CrochsDevs/Water-Monitoring-System/(commit log)

2026-05-26 feat: Creating history for three devices including the history of readings
2026-05-27 Add comprehensive Data Flow Diagram with both systems, processes, decisions, and logic
2026-05-31 Add Arduino sketches, serial tools, and finalized Phase 2 procurement
    Arduino:
    - arduino/rice_field_monitor_sim800l.ino — SIM800L (GPRS + SMS fallback)
    - arduino/rice_field_monitor_air780e.ino — Air780E 4G LTE (HTTP + SMS)
    Tools:
    - tools/serial_monitor.py — Full serial monitor with JSON parsing
    - tools/quick_monitor.py — Minimal raw serial reader
    Docs:
    - docs/BENCH_TESTING.md — 6-phase bench testing protocol
    - docs/CLIENT_DOCUMENTATION.md — Full device spec for thesis
    - docs/PROCUREMENT.md — Finalized with 10W panel, 7AH battery, field visit note
2026-06-01 Add minimal Phase 2 buy list — 7 essential items for client procurement
2026-06-01 Update Phase 2 minimal list — add mounting hardware (clamps, brackets, bolts)
2026-06-02 Deploy Docker stack: MySQL + PHP/Nginx dashboard, API endpoint, serial bridge, Arduino JSON output
    - Docker Compose: MySQL 8.0, PHP 8.2-FPM, Nginx, phpMyAdmin
    - New schema: water_level_readings table (device_id, level, distance, battery, signal, alert)
    - api/reading.php: POST endpoint for Arduino data (no auth, JSON body)
    - api/history_data.php: refactored for water level + battery chart data
    - pages/dashboard.php: water level gauge, battery/signal stats, 24h trends
    - pages/history.php: water level history with Chart.js, filter by hour/day/week/month/year
    - tools/serial_bridge.py: reads Arduino JSON over USB serial, POSTs to dashboard
    - Arduino sketch: JSON serial output for bridge, keep SIM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
2026-06-02 Dashboard: 3 devices (RF01/RF02/RF03), remove battery/signal, multi-device chart
    - Dashboard shows 3 device cards with colored gauges per device
    - 'Latest Water Level Retrieved' label with timestamp per card
    - Battery voltage and signal strength removed
    - History chart shows 3 lines (RF01=blue, RF02=green, RF03=amber)
    - history_data.php returns data for all 3 devices simultaneously
    - Seed data includes 500 readings each for RF01, RF02, RF03
    - Alerts list shows device_id tag
2026-06-06 Add mock deployment: USB bridge + wiring diagram + test sketch for 3 Unos
2026-06-06 Add wiring diagram: JSN-SR04T + LCD + reserved SIM pins for 3 Unos
2026-06-11 Add LTE bridge: Arduino USB -> PC -> A7680C USB -> 4G LTE -> Dashboard
2026-06-19 Add module monitor: test A7680C UART responses via ESP32
2026-06-19 Add ESP32 WiFi sketch + wiring diagram
